Multiflexmeter/Multiflexmeter/readme.md

# Multiflexmeter V4
Frequent, low-cost and flexible measurements using the MultiFlexMeter. An Open-Source sensor platform.

## Documentation

- [Firmware Documentation](https://multiflexmeter.github.io/multiflexmeter)
- [Hardware specification](./docs/P22296-1-SPEC-2.0.pdf)
- [Firmware specification](./docs/P22296-10-SPEC-2.0.pdf)
