Multiflexmeter/Multiflexmeter/accessories/well_adapter_115mm_160mm/readme.md

## Well adapter

3D printable files for attaching a MFM to a groundwater well of two diameters (115mm and 160mm). Including a mounting cap and side adapter.

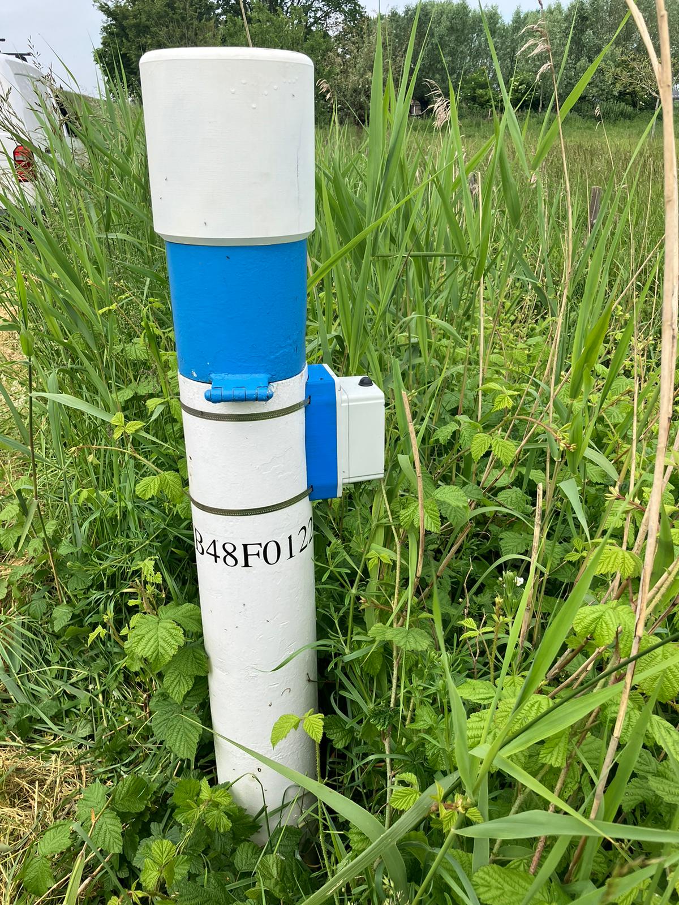
[picture p1: accessories/well_adapter_115mm_160mm/IMG-20240524-WA0001.jpg]
Sideview of a groundwater well with a MultiFlexMeter attached to it using this adapter


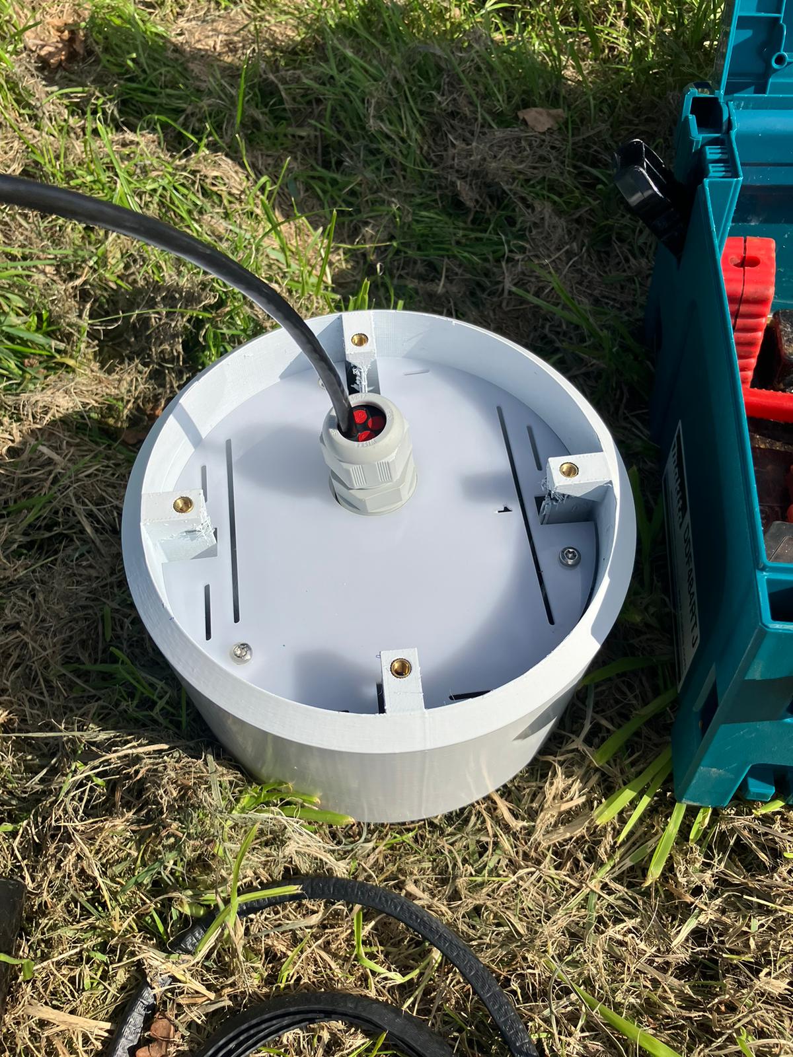
[picture p2: accessories/well_adapter_115mm_160mm/IMG-20241004-WA0002.jpg]
Assembled but not attached groundwater well cap view
