Multiflexmeter/Multiflexmeter/accessories/well_adapter_115mm_160mm/3D Well Cap temporary.step

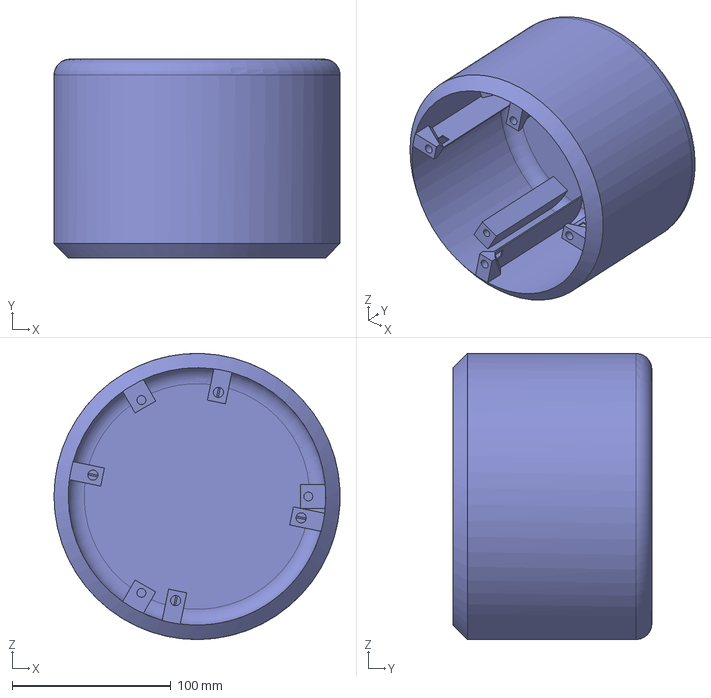
[picture p13: CAD file, 2025-04-15]
accessories/well_adapter_115mm_160mm/3D Well Cap temporary.step
179.9 x 125.0 x 180.0 mm
