Multiflexmeter/Multiflexmeter/accessories/well_adapter_115mm_160mm/Adapter_MFM-V4_160mm.SLDPRT

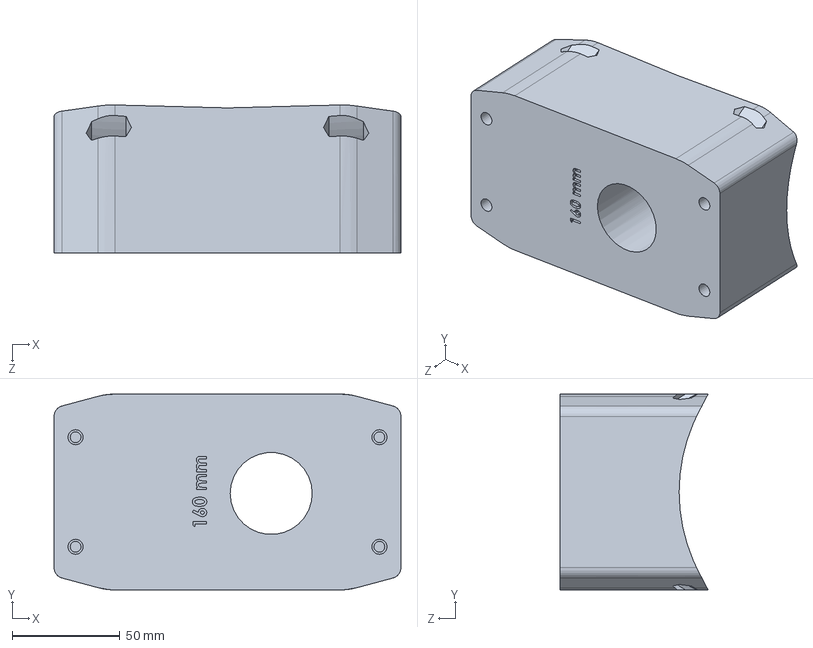
[picture p14: CAD file, 2025-04-15]
accessories/well_adapter_115mm_160mm/Adapter_MFM-V4_160mm.SLDPRT
160.8 x 90.8 x 68.6 mm
