Multiflexmeter/Multiflexmeter/accessories/well_adapter_115mm_160mm/Adapter_MFM-V4_115mm.SLDPRT

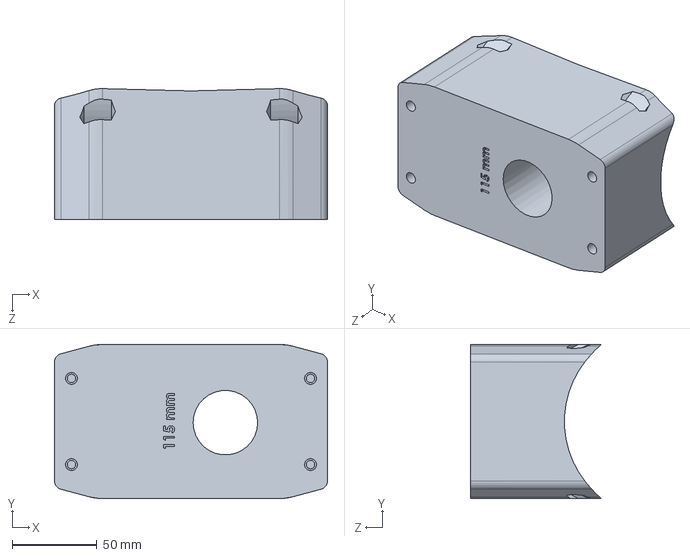
[picture p15: CAD file, 2025-04-15]
accessories/well_adapter_115mm_160mm/Adapter_MFM-V4_115mm.SLDPRT
160.8 x 90.8 x 77.0 mm
