Multiflexmeter/Multiflexmeter/accessories/well_adapter_115mm_160mm/3D Cap Electronics platform 160mm.step

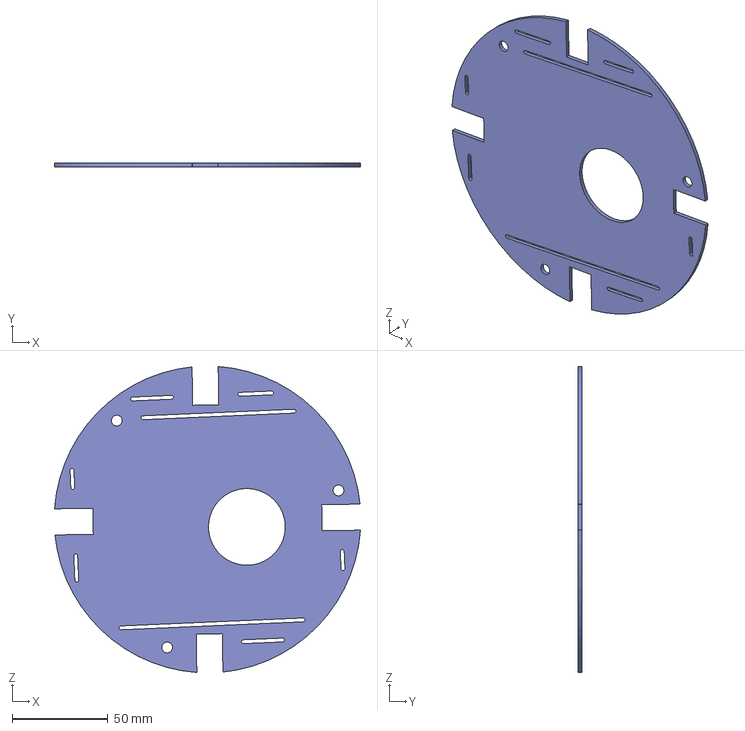
[picture p16: CAD file, 2025-04-15]
accessories/well_adapter_115mm_160mm/3D Cap Electronics platform 160mm.step
159.6 x 2.00 x 159.6 mm
