Multiflexmeter/Multiflexmeter/(list of files, cad)

Other CAD files:
accessories/well_adapter_115mm_160mm/3D Well Cap 160mm.stl
accessories/well_adapter_115mm_160mm/Adapter_MFM-V4_115mm.STL
accessories/well_adapter_115mm_160mm/Adapter_MFM-V4_160mm.STL
