Multiflexmeter/Multiflexmeter/(list of files, drawings)

Other design files:
hardware/BatteryMonitor.SchDoc
hardware/MCU.SchDoc
hardware/MCU_RF.SchDoc
hardware/Mechanical.SchDoc
hardware/Memory.SchDoc
hardware/P22296-1.PrjPcb
hardware/Power1.SchDoc
hardware/Power2.SchDoc
hardware/Revison Table.SchDoc
hardware/RTC.SchDoc
hardware/Sensor.SchDoc
hardware/SensorSlot1.SchDoc
hardware/SensorSlot2.SchDoc
hardware/TopLevel.SchDoc
hardware/USB.SchDoc
