Multiflexmeter/Multiflexmeter/src/Core/Src/main.c

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
/* Includes ------------------------------------------------------------------*/
#include "main.h"
#include "crc.h"
#include "app_fatfs.h"
#include "i2c.h"
#include "iwdg.h"
#include "app_lorawan.h"
#include "spi.h"
#include "usart.h"
#include "gpio.h"

/* USER CODE BEGIN Includes */
#include "sys_app.h"
#include "../../App/mainTask.h"
#include "../../App/productiontestTask.h"
#include "../../App/CommConfig.h"
#include "../../App/dataflash/dataflash_functions.h"
#include "../../App/measurement.h"
#include "../../App/MFMconfiguration.h"
#include "../../App/common/common.h"
/* USER CODE END Includes */


/* USER CODE BEGIN PV */
#ifdef  USE_FULL_ASSERT
uint32_t assert_failed_count;
#endif
/* USER CODE END PV */

void SystemClock_Config(void);
/* USER CODE BEGIN PFP */

void SystemClock_Config_MSI_RC(void);


/* USER CODE END PFP */

/* USER CODE BEGIN 0 */
static int8_t resultInitDataflash;

#ifdef ERASE_DATAFLASH
#warning ERASE_DATAFLASH at boot enabled
bool chipErase = true;
#endif

#ifdef ERASE_VIRTUAL_EEPROM
#warning ERASE_VIRTUAL_EEPROM at boot enabled
bool eraseVirtualEeprom = true;
#endif

/* USER CODE END 0 */

/**
  * @brief  The application entry point.
  * @retval int
  */
int main(void)
{
  /* USER CODE BEGIN 1 */
  detectResetBackup(); //detect if the vBAT backup domain is reset, must be executed before init.
  /* USER CODE END 1 */

  /* MCU Configuration--------------------------------------------------------*/

  /* Reset of all peripherals, Initializes the Flash interface and the Systick. */
  HAL_Init();

  /* Configure the system clock */
  SystemClock_Config();

  /* Initialize all configured peripherals */
  MX_GPIO_Init();
  MX_CRC_Init();
  MX_SPI1_Init();
  MX_I2C1_Init();
  MX_I2C2_Init();
  MX_FATFS_Init();
  MX_LoRaWAN_Init();
  MX_USART2_UART_Init();
  MX_IWDG_Init();
  /* USER CODE BEGIN 2 */

  uartInit_Config();
  resultInitDataflash = init_dataflash();

#ifdef ERASE_DATAFLASH
  if( chipErase )
  {
    chipEraseDataflash();
  }
#endif

#ifdef ERASE_VIRTUAL_EEPROM
  if (eraseVirtualEeprom == true)
  {
    eraseVirtualEEPROM();
  }
#endif

  restoreLatestMeasurementId();
  reloadSettingsFromVirtualEEPROM();

  APP_LOG(TS_OFF, VLEVEL_H, "Testmode: %d\r\n", getStatusRegister().testmodeActive);

  /* check production testmode is active or normal operation mode */
  if( getStatusRegister().testmodeActive )
  {
    init_productiontestTask();
  }
  else if( getStatusRegister().testmodeBatteryGauge )
  {
    init_batmonConfigTask();
  }
  else
  {
    init_mainTask();
  }

  /* USER CODE END 2 */

  /* Infinite loop */
  /* USER CODE BEGIN WHILE */
  while (1)
  {
    /* USER CODE END WHILE */
    MX_LoRaWAN_Process();

    /* USER CODE BEGIN 3 */
  }
  /* USER CODE END 3 */
}

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
