Multiflexmeter/Multiflexmeter/src/App/dataflash/dataflash_functions.c

/*
 * dataflash_functions.c
 *
 *  Created on: 23 aug. 2023
 *      Author: p.kwekkeboom
 */

#include "spi_driver.h"
#include "standardflash.h"
#include "helper_functions.h"
#include "dataflash_functions.h"

static uint8_t MID[] = {0x1F, 0x88, 0x01};
static uint8_t dataRead[MAXIMUM_BUFFER_SIZE] = {0};


static uint8_t writePageBuffer[PAGE_SIZE_DATAFLASH];
static uint8_t readPageBuffer[PAGE_SIZE_DATAFLASH];
static uint8_t block4kBuffer[BLOCK_4K_SIZE_DATAFLASH];

/**
 * @fn const void setup_io_for_dataflash(bool)
 * @brief weak function to be override in application for enable I/O for FRAM operations
 *
 * @param state
 */
__weak const void setup_io_for_dataflash(bool state)
{
  UNUSED(state);
  __NOP();
}

/**
 * @fn void standardflashWaitOnReadyWithTimeout_printResult(void)
 * @brief helper function to catch the result.
 *
 */
void standardflashWaitOnReadyWithTimeout_printResult(void)
{
  bool result = standardflashWaitOnReadyWithTimeout();

  if ( result )
  {
    APP_LOG(TS_OFF, VLEVEL_H, "DATAFLASH: ERROR, timeout at Wait on ready\r\n");
  }
}


/**
 * @fn int init_dataflash(void)
 * @brief function to initialize the Dataflash I/O and read the Manufacturer ID
 *
 * @return 0 = success, -1 = failed.
 */
int8_t init_dataflash(void)
{
  int result = 0;
  //enable io needed for dataflash
  setup_io_for_dataflash(true);

  // initialize the I/O
  SPI_ConfigureSingleSPIIOs();

  //read the MD to verify dataflash
  standardflashReadMID(dataRead);

  //check MID is okay
  if (compareByteArrays(dataRead, MID, 3))
  {
    APP_LOG(TS_OFF, VLEVEL_H, "Dataflash: ReadMID Success.\r\n");
    result = 0;
  }
  else
  {
    APP_LOG(TS_OFF, VLEVEL_H, "Dataflash: ReadMID fail.\r\n");
    result = -1;
  }

  //disable io needed for dataflash
  setup_io_for_dataflash(false);

  return result;
}

/**
 * @fn int8_t writePageInDataflash(uint32_t, uint8_t*, uint32_t)
 * @brief function to write a page in dataflash
 *
 * @param pageAddress : start address of page, must be align on page size \ref PAGE_SIZE_DATAFLASH
 * @param data : pointer to data buffer to write, no zero.
 * @param length : length of data to write, must be > 0
 * @return 0 = successful, -1 = data pointer is zero, -2 = length is zero, -3 = length is larger then one page size \ref PAGE_SIZE_DATAFLASH
 */
int8_t writePageInDataflash(uint32_t pageAddress, uint8_t * data, uint32_t length)
{
  assert_param(data != 0 ); //check pointer is not zero
  assert_param(length != 0 ); //check length is not zero
  assert_param(length <= PAGE_SIZE_DATAFLASH ); //check length is not too large

  if( data == 0 ) //check pointer is zero
  {
    return -1;
  }

  if( length == 0 ) //check length is zero
  {
    return -2;
  }

  if( length > PAGE_SIZE_DATAFLASH ) //check length is larger then 256
  {
    return -3;
  }

  //enable io needed for dataflash
  setup_io_for_dataflash(true);

  //set pageBuffer as empty value
  memset(writePageBuffer, 0xff, sizeof(writePageBuffer));

  //read dataflash block
  standardflashReadArrayLowFreq(pageAddress, dataRead, length < sizeof(dataRead) ? length : sizeof(dataRead));

  //check if location is empty
  if (memcmp( dataRead, writePageBuffer, sizeof(writePageBuffer)) )
  {
    APP_LOG(TS_OFF, VLEVEL_H, "Page %d is not empty.\r\n", pageAddress);
  }

  //enable write
  standardflashWriteEnable();

  //write data
  standardflashBytePageProgram((uint32_t)pageAddress, data, length);

  //wait for ready
  standardflashWaitOnReadyWithTimeout_printResult();

  //disable io again
  setup_io_for_dataflash(false);

  return 0;
}

/**
 * @fn int8_t writeMeasurementInDataflash(uint32_t, uint8_t*, uint32_t)
 * @brief function to write a measurement item "measurementId" in the dataflash ringbuffer.
 *
 * @param measurementId number starts from 0 - 4294967296
 * @param data array of data
 * @param length of data array to write, limit to 256 (\ref PAGE_SIZE_DATAFLASH).
 * @return 0 = successful, -1 = data pointer is zero, -2 = length is zero, -3 = length is larger then one page size \ref PAGE_SIZE_DATAFLASH
 */
int8_t writeMeasurementInDataflash(uint32_t measurementId, uint8_t * data, uint32_t length)
{
  assert_param(data != 0 ); //check pointer is not zero
  assert_param(length != 0 ); //check length is not zero
  assert_param(length <= PAGE_SIZE_DATAFLASH ); //check length is not too large

  if( data == 0 ) //check pointer is zero
  {
    return -1;
  }

  if( length == 0 ) //check length is zero
  {
    return -2;
  }

  if( length > PAGE_SIZE_DATAFLASH ) //check length is larger then 256
  {
    return -3;
  }

  uint64_t pageAddress = (measurementId * PAGE_SIZE_DATAFLASH);
  pageAddress %= MEASUREMENT_MEMEORY_SIZE;

  return writePageInDataflash((uint32_t)pageAddress, data, length);
}
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
