Multiflexmeter/Multiflexmeter/(commit log)

2023-04-13 intial commit.
    Project generated with ioc file saved in "P22296-10-SW IOC stm32 template 2023-04-13.zip"
    Settings based on example "LoRaWAN_End_Node".
2023-04-13 change: add "../Drivers/BSP/STM32WLxx_Nucleo" to include path in eclipse project settings.
2023-04-13 change: take over changes of LoraWAN_End_Node changes of example. Extra: place LED driving betweend #ifdef.
2023-04-24 change: enable TIM2 with interrupt for app timer.
2023-04-24 change: enable debugger. Use Undef to prevent every time reset by code generation.
    [sys_conf.h]
2023-04-24 change: disable TIM2, does not work with STOP2 mode. Hardware error.
    [main.c, stm32wlxx_it.c]
2023-04-25 change: correct #ifdef for LED2.
    [lora_app.c]
2023-04-25 change: add app/common files app_types.h and uart.c
2023-04-25 change: add some code for uart config handling.
2023-05-11 change: basis implementation of uart CONFIG send / read structure.
2023-05-11 change: enable UART callback in IOC and code.
2023-05-16 fix: switch arround by mistake of commandGet / commentSet
    [CommConfig.c]
2023-05-16 fix: wrong assert sign is used.
    [CommConfig.c]
2023-05-17 change: add commands Get+SensorInfo, Get+JoinID, Get+DeviceID, Get+AppKey
2023-05-17 change: add command Get+Sensor=X
2023-05-22 fix: correction of number of arguments of Get+LeesInterval en Get+MeetTijd
    [CommConfig.c]
2023-05-22 change: add new command Set+Sensor
2023-05-22 fix: skipp comma reading.
    [CommConfig.c]
2023-08-11 Add: Enable I2C1 for the internal bus with internal pullups for testing
2023-08-11 Add: Added library from ambic and changed the private functions to work with STM32
    (cherry picked from commit c0532baad6d5c6d7373273510c6734e729f9e088)
2023-08-11 Changed i2c handle from i2c2 to i2c1
2023-08-11 change: add set DeviceId command to overrule chip deviceId
2023-08-11 Refactor: Corrected the indentation and whitespacing
    [am1805.c, am1805.h]
2023-08-16 change: set at init LoraWan : ADREnable = false and Datarate = DR_2 (SP10). Decrease Datarate if join failed.
    [lora_app.c]
2023-08-16 Revert "change: config, Lorawan version from 1.0.3 to 1.0.4 in cubeMx project file"
    This reverts commit 7ef1d0bc230a0cca72d6b3f9c399aeb51bf8f0e7.
    [P22296-10-SW.ioc]
2023-08-16 Change: tested am1805_sqw_set. Works on pin CKO but not on FOUT or PSW pin. Alarm function also doesn't work on these pins.
    [am1805.c, am1805.h, main.c]
2023-08-16 Docs: Updated the comments to only AM1805 because SPI is not supported/needed at the moment
2023-08-16 Change: Added global define for the i2c handle
2023-08-16 change: add *.launch file, *.stackdump and .settings/stm32cubeide.project.prefs to ignore. Files can give conflicts if changes are commit.
2023-08-16 Add: Add library for communicating to the sensor module
    (cherry picked from commit 20ac5bdaa4915cb763f8f0591adfdb417dcb24e0)
2023-08-16 Add: added files for the battery monitor with basic defines for the registers and commands
    (cherry picked from commit 646b38ebbe7aba5a357235ba6925f0fcf9704114)
2023-08-16 Add: added read voltage function and tested the init and read voltage functions
2023-08-16 change: enable SPI1 on PA5, PA6, PA7 in configuration file stm32cube
2023-08-16 Add: Added read current and temperature functions
2023-08-16 Change: changed the i2c handle to variable to a pointer so a check can be done if it isn't NULL
2023-08-17 change: add sourcefiles from https://github.com/adestotechnologies/Flash-Drivers/tree/master/source Not yet compilable
2023-08-17 change: modify library to compile without error. Not yet working.
    [main.c, standardflash.c, user_config.c, user_config.h]
2023-08-17 change: prevent warnings of printing uint32.
    [helper_functions.c, test.c]
2023-08-18 Add: added security mode check. always results in 0 because the and operation is not working correctly. Needs to be fixed.
    [bq35100.c, bq35100.h, main.c]
2023-08-18 Add: added function to get the design, used and remaining capacity
2023-08-21 Add: added gauge enable and disable functions. Disable function is pretty long in now. Need to add a parameter to ignore the checking if the device is really off.
2023-08-21 Change: added parameter to skip the check function to save time
    [bq35100.c, bq35100.h, main.c]
2023-08-21 Change: added commands directly to i2c function
2023-08-21 Fix: fixed the get security mode function
    [bq35100.c, bq35100.h, main.c]
2023-08-23 Change: added the internal temperature function and changed output form float to a int16_t to minimize the size needed.
2023-08-23 change: add dataflash device AT25QF641B. has different manufacturer ID. 0x1f 0x88 0x01.
2023-08-23 change: macro for printing debug information of driver to debug com-port.
2023-08-23 Revert "change: add testcode for dataflash testing."
    This reverts commit dc5340fcaeee9f2e60473f04ce80dc56ec418ca1.
    [main.c]
2023-08-23 change: move printf override to helper_functions.h
2023-08-23 Fix: used printf for logging does not support %lu.
    [helper_functions.c]
2023-08-23 change: addon "dataflash" in print log.
2023-08-24 Revert "change: testing dataflash test function."
    This reverts commit 3ff5dd0403358a8ca5541797c43011fefc0e8966.
    [main.c]
2023-08-24 Revert "change: testcode to verify function arguments."
    This reverts commit c85f6f5a128558a50869bf7b8cdb23863726166c.
    [main.c]
2023-08-25 Revert "change: test temporary with smaller ring buffer."
    This reverts commit 816dbefc2b79bc19a6899810e834cc69d34243df.
    [dataflash_functions.h]
2023-08-30 Revert "change: add testcode for dataflash write and searching."
    This reverts commit 2c311ad7943dbc62c44c683d2f1c77fdde448cbf.
    [main.c]
2023-08-30 Change: fixed enable function
    [bq35100.c]
2023-08-31 change: add function to activate uart in listen mode until timeout.
2023-08-31 change: test code to activate uart config listing at every TX send period. Needs to change to activation by USB connection.
2023-08-31 change: fix on 8347306d37b9b11098eccd103a8118cd8ef49ab1 wrong variable name used.
    [CommConfig.c]
2023-08-31 change: implementation of printing the dataDump.
2023-09-04 change: fix in uart interrupt, first check pointer is not zero.
    After a poweron boot the interrupt is triggered when pointer is not yet set.
    This gives an hard fault.
    [uart.c]
2023-09-04 change: add common.c and common.h file with functions for resetCause and backup registers.
    [common.c, common.h]
2023-09-04 change: add check on PowerOnReset() for skipping backup registers.
2023-09-04 change: testcode for delay powerup for testing and debugging.
2023-09-12 Revert "change: testcode for delay powerup for testing and debugging."
    This reverts commit b6daf899d905b69424d6644d9c1f0f0ba6d71e3a.
2023-09-12 change: correction of define name, by mistake 62 must be 64.
    [dataflash_functions.h]
2023-09-13 change: correction of casting variable in printf function
    [CommConfig.c]
2023-09-13 change: reload unique ID when 0x00 is set as DeviceId.
2023-09-13 change: fix to make it possible to read also input of 16 characters or less.
    [CommConfig.c]
2023-09-14 change: add ST driver EEPROM_Emul to project
2023-09-18 change: add clock initialize for XTAL 8Mhz, TCXO 8Mhz, TXCO 32Mhz (nucleo board) and backfall MSI RC
2023-09-19 change: disable (test) erase of virtual memory at powerup.
2023-09-19 change: code change of code generation. Forgotten to revert in commit 049ade5b70a1da988efcd925b8ba6e801321ef29
    [main.c]
2023-09-19 change: return real HAL_GetTick() if RTC timer not yet enabled.
2023-09-19 Change: disable flash init function because fatfs function do not work otherwise. Used another library found at https://github.com/eziya/STM32_SPI_SDCARD
    [P22296-10-SW.ioc, main.c, main.h, spi.c, stm32wlxx_it.c]
2023-09-20 Change: made use of the hal spi function. Can be toggled by define in spidriver.h. IO method is faster but can be used simultaneously with the sd card
2023-09-20 Change: disabled hal function spi for now because SD card is not attached
2023-09-20 Change: sped up the spi transmit by sending and receiving multiple bytes instead of byte for byte. 10ms faster.
2023-09-20 Change: disable hal spi driver
2023-09-22 change: temporary disable TCXO for Dekimo board, gives troubles with clock init.
2023-09-26 change: add counter for monitoring time request sending/receiving. Failed sometimes.
    [lora_app.c]
2023-09-27 change: enable HAL driver for dataflash.
2023-09-27 change: add functions to read ADC
2023-09-27 change: add commands for software version and ADC test.
2023-09-27 change: lower the SPI speed, because of problems on evaluation board with SD card reading. TODO: on target board to higher frequency.
    [P22296-10-SW.ioc]
2023-09-27 change: change: lower the SPI speed, because of problems on evaluation board with SD card reading, only code change of 1ff1333a45433c9c3a4ca0e753d30ac544f4395d.
    [spi.c]
2023-09-27 change: cubeMx configuration file, make sure CS for SD is high at power.
2023-09-27 change: Make sure CS for SD is high at power. code change of previous commit 8e6d512d24e55d91f38071ffa9d9c80e46212d63
2023-09-28 change: call power_off() when init failed and implement of return power status command.
2023-09-28 change: remove double definition. Use definition of "diskio.h" from STM32 example project of http://elm-chan.org/
2023-09-28 change: replace fatfs timer function for disk_timerproc().
    [stm32wlxx_it.c]
2023-09-28 change: expand SD test with capacity and number of bytes free
2023-09-28 change: move I2CMaster files
2023-09-29 change: trigger uartListen for debug/testing
2023-09-29 change: code generation of Wakeup pin PA4
2023-09-29 change: configuration cubeMX enable "Set all free pins as analog (to optimize the power constumption).
2023-09-29 change: code change of previous commit 833b183b65654f7cb7d10b36bf333ba29684ef24 configuration cubeMX enable "Set all free pins as analog (to optimize the power constumption).
2023-09-29 change: add wake-up interrupt
2023-09-29 Revert "change: configuration cubeMX enable "Set all free pins as analog (to optimize the power constumption)."
    This reverts commit 833b183b65654f7cb7d10b36bf333ba29684ef24.
    [P22296-10-SW.ioc]
2023-09-29 Revert "change: configure Wake-up 0 (PA0)"
    This reverts commit fd2492f919e001a4be26095d0180f95f2230bd33.
    [P22296-10-SW.ioc]
2023-09-29 Revert "change: code generation of Wakeup pin PA4"
    This reverts commit 66540e15caf5f866161f55a1b026fc140ec32357.
    [main.h]
2023-09-29 change: code change of previous commit e8b44b3a607451c4b2983a05ee77be215bd47c60. Enable PC13 as wakeup pin.
2023-09-29 Revert "change: code change of previous commit e8b44b3a607451c4b2983a05ee77be215bd47c60. Enable PC13 as wakeup pin."
    This reverts commit 97e88effcbbb649effed55e8c3ba2f9439287230.
    [main.h]
2023-09-29 Revert "change: enable PC13 for wake-up in cubeMx configuration file"
    This reverts commit e8b44b3a607451c4b2983a05ee77be215bd47c60.
    [P22296-10-SW.ioc]
2023-09-29 change: save CLK configuration before STOP2 mode, set back enter wake up.
    Otherwise the clock runs too slow and uart receive will not work.
    [stm32_lpm_if.c]
2023-10-03 Revert "change: read out time for testing."
    This reverts commit f73e5a435a7cf48123a6e7ec58cbe828f315ef8e.
    [stm32_lpm_if.c]
2023-10-03 Revert "change: test on clk before resume"
    This reverts commit 15d1db8b26a282e45e9fa882a10037ab539c8b4f.
    [stm32_lpm_if.c]
2023-10-03 Revert "change: test code to activate uart config listing at every TX send period. Needs to change to activation by USB connection."
    This reverts commit beee27ae158b35c99e2c04949711035b672f46f7.
    [lora_app.c]
2023-10-03 change: cubeMx only, enable I2C channel 2 on PA11 and PA12. Standard mode 100Khz.
2023-10-03 change: code change of enable I2C channel 2
2023-10-04 change: add TCA9535 I2C driver, based on SLVC564 I/O Expander Software and Firmware Package (https://www.ti.com/tool/download/SLVC564)
2023-10-05 change: rewrite some functions to handle a more flexiable way for supporting multiple I/O expanders on different address and on different I2C bus peripherals.
2023-10-05 change: process return value of I2C_Write() in init.
2023-10-05 change: make difference between powerup and wakeup from STOP2
2023-10-09 change: add set/reset functions for register variable
    [IO_Expander.c]
2023-10-09 change: use set/reset register function.
    [IO_Expander.c]
2023-10-10 change: add a first definition of board_io
2023-10-10 change: split up init function with init a pin.
2023-10-10 change: implement init function of board IO (only of IO expander).
2023-10-10 change: fix invert IS_GPIO_PIN()
    [IO_Expander.c]
2023-10-10 change: add functions to update, write and read board IO. Also rewrite of IO expander functions related to new functions
2023-10-10 change: use defines for port definition based on target NUCLEO (evaluation board) or Dekimo board.
2023-10-11 Change: add LED functions
2023-10-11 change: add LED test function call from command
2023-10-11 change: prevent double definition of true and false
    [app_types.h]
2023-10-11 change: call init LED timer to start LED functions
2023-10-11 Add: enabled I2C2
2023-10-11 Add: added function to set the amount of samples and updated the register sizes
2023-10-11 Add: added read samples function
2023-10-12 Add: added read and write setup time of the sensor
2023-10-12 change: use LED1 and LED2 of evaluation board.
2023-10-12 fix: worng enum type was used.
    [board_io.c, board_io.h]
2023-10-12 change: make board_io functions const
2023-10-12 change: rewrite led function to support mode (LED_DISABLED) for direct control of I/O of output by board_io functions.
2023-10-12 change: add missing comments and doxygen header.
    [CommConfig.c]
2023-10-13 change: I2C-2 was allready enabled in cubeMx file, but item was missing ",14-MX_I2C2_Init-I2C2-false-HAL-true" in config file.
    [P22296-10-SW.ioc]
2023-10-13 change: Lora protocol version from 1.0.3 to 1.0.4.
    Needed for resume session after power down without a new Join.
    Protocol version 1.0.3 will cause every powerdown cycle a new Join.
2023-10-13 change: correct device type FRAM
    [FRAM.c]
2023-10-16 Change: CubeMx config file for UFQFPN48 device.
2023-10-17 change: disable other CLOCK inits (executing failed on current target).
    [main.c]
2023-10-17 change: Use dekimo board, not nucleo defines for Port IO.
2023-10-17 change: add test code for toggle LED, for board testing.
2023-10-18 Enable i2c interrupts
2023-10-18 Fix: wrong index was used.
    [IO_Expander.c]
2023-10-18 fix: wrong argument checking sign was used.
    [TCA9535.c]
2023-10-18 fix: shift address one position.
    [TCA9535.c]
2023-10-18 change: test code for I2C scanning.
2023-10-19 Add: added read function for the selected sensor
2023-10-23 change: rewrite of I/O expander init function for call init for each device separatly.
2023-10-23 change: I2C peripheral device switched arround
2023-10-23 Fix: wrong index used in I2C_write
    [TCA9535.c]
2023-10-25 change: add uart test function, for hw test.
2023-10-25 Revert "change: testing Usart1."
    This reverts commit fdb8d45ce989963a1ea92f92f662ed31ff5c1532.
    [main.c]
2023-10-25 Revert "change: disable some items for testing usart1."
    This reverts commit 0f2a975731eae5200b96759f76868161385e24c1.
    [main.c]
2023-10-25 Revert "change: add uart test function, for hw test."
    This reverts commit 57283215712961c49bb981143eb5d47e09791bcd.
    [CommConfig.c, main.c]
2023-10-25 change: use inverted level for IO_LOW_ACTIVE pins.
    [board_io.c]
2023-10-25 change: enable SPI.
2023-10-25 Revert "change: test dataflash hardware test."
    This reverts commit b1e8e8c41e6c4aef28c4098c13e4462e84ec144d.
    [main.c]
2023-10-25 change: implement board specific LoRa FE_control
2023-10-25 change: enable other items, cleanup test code I2C
2023-10-26 change: use right CS pin for SD card.
2023-10-26 change: first enable SPI before LoraWan. Needed if NVIC data is saved in FRAM. Temporary outside cubeMx. Needs to be done in CubeMx.
2023-10-26 change: order of periperhal init, move SPI init before LoRaWAN init. Only CubeMx file.
2023-10-26 change: code generation of previous commit. Order change SPI before LoraWan.
2023-10-26 change: I2C move before LoraWan init
2023-10-26 change: move I2C init before LoraWan Init. Code change of previous commit.
2023-10-26 Revert "change: code change of previous commit. Order of init periperhals. Place LoraWan_init at end. Place usart together. Place CRC in front."
    This reverts commit a4639beebcb14ac972889dd1c80e4309d09d0931.
    [main.c]
2023-10-26 test: temporary set LED1 to blink for test.
2023-10-30 change: correct PC13 from input to output. Only CubeMx config file
    [P22296-10-SW.ioc]
2023-10-31 change: correct OSC clock frequency from 8 to 32Mhz
    [P22296-10-SW.ioc]
2023-11-06 fix: by mistake struct definition and filling of stIO_PinConfig the first two column switch arround.
    [board_io.h]
2023-11-06 Fix: fixed the 2nd IO expander not working
    [board_io.h]
2023-11-06 change: add test functions for Battery monitor
2023-11-07 fix: blocknumber must be multiplied with blocksize, to get the right start address.
    [dataflash_functions.c]
2023-11-07 fix: clear argument string, if no arguments are available.
    [CommConfig.c]
2023-11-07 change: add functions to switch input/output.
2023-11-07 Change: enabled the interrupt of the I2C2 bus because otherwise the measurement communication fails
    [P22296-10-SW.ioc]
2023-11-07 Change: updated files for enabled I2C interrupt
2023-11-09 Remove: removed sensor data structs because data lenght is provided via the I2C communication
2023-11-21 change: trigger save NVM to FRAM in SendTxData() gives problems with receiving data on gateway. Trigger moved to OnTxTimerEvent().
    [lora_app.c]
2023-11-22 change: expand I2C sensor functions with datalength argument
2023-11-22 change: split up board_io functions in plane board_io, test and functional.
2023-11-22 change: add function to control sensor slot power.
2023-11-22 fix: on a8da4a8f9e00dc645ac8454469836140223e411c. Needs to be memset(), not memcpy().
    [I2C_Master.c]
2023-11-22 change: rewrite of sensor functions with the use of sensor number, not I2C address.
2023-11-22 change: rewrite enum I2C error.
    [I2C_Master.c, I2C_Master.h]
2023-11-22 change: rewrite sensor function return type.
2023-11-22 change: correction no dataLength needed.
    [SensorFunctions.c, SensorFunctions.h]
2023-11-22 change: add missing funtion in header.
    [MFMconfiguration.h]
2023-11-22 change: add a first implementation of reading sensor data.
2023-11-22 change: some improvements and new features: save module ID to FRAM, read module ID at start. Fix in increment ModuleId. Switch off power of slot after measure.
    [FRAM_functions.c, FRAM_functions.h, mainTask.c]
2023-11-23 fix: calculate supply for VBUS measure.
    [CommConfig_usr.c, common.h]
2023-11-27 fix: [2] is too less, needs to be at least [3] for null terminator. [] also works fine.
    [CommConfig.c]
2023-11-27 change: add enum for sensor types and struct for sensor data type for debug purposes only.
2023-11-27 change: add debug print of formated sensor data.
2023-11-27 Fix: getSensorStatus() uses sensor number from 1-6, for communication and algoritme 0-5.
    [mainTask.c]
2023-11-28 change: expand log function with sensor slot Id.
2023-11-28 change: update mainTask to measure pericall one sensor module and trigger the SendTxData (lora transmit).
2023-11-28 change: update tx interval in Lora_app based on max of forced and current. Reading setting lora_interval removed, done in MainTask now.
2023-11-28 fix: user code on wrong location.
    [lora_app.c]
2023-11-28 change: save NVM data after TX in lora_app.c and if tx failed in mainTask
    [lora_app.c, mainTask.c]
2023-11-28 change: expand logdata with sensor protocol
2023-11-28 change: rewrite of sensorFunctions with error result.
    [SensorFunctions.c, SensorFunctions.h, app_types.h, mainTask.c]
2023-11-28 change: cubeMx file. Lower prescaler from 8 to 2. SPI baudrate lowered because of internal clock 48Mhz -> 4Mhz from 6Mbits/s -> 500KBits/s. With prescaler on 2 it will be 2.0Mbits/s
2023-11-28 change: cubeMx file 4Mhz to 2Mhz. SPI degrades from 2.0Mbits/s to 1.0Mbits/s
2023-11-29 change: move resume mainTask to MainTask measurement timer.
2023-11-29 change: rewrite UartConfig active with TIMER
2023-11-29 change: trigger uart to accept data.
2023-11-29 change: add uartKeepListen() function to keep uart in listen mode (no STOP2 mode will be active).
2023-11-29 change: get USB connected input to set uartKeepListen(). If USB is connected the STOP2 mode is not activated.
2023-11-29 change: move board I/O functions from mainTask.c to board_io_functions.c
2023-11-29 change: add init_board_io_device() to init each device seperatly.
2023-11-29 change: also switch on/of vSys for test FRAM function
2023-11-29 change: some optimization for speed / power.
2023-11-29 change: save sensor protocol and type globally in mainTask.c, so it can be used at later state. This saves some time / energy.
2023-11-30 change: enable green LED by Lora Uplink
2023-12-04 change: add application functions to measure battery monitor data
2023-12-04 change: add measure battery monitor in mainTask
2023-12-04 Fix: remove komma at end of line.
    [mainTask.c]
2023-12-04 change: move init batMonitor to mainTask Must be after board "init_board_io()"
2023-12-04 change: rewrite mainTask to wait for Battery measuredment data.
2023-12-04 change: save request time to backup registers, to prevent every switch off by RTC a downlink.
    [common.h, lora_app.c, lora_app.h]
2023-12-04 change: print also number of seconds in sleep.
2023-12-04 change: use minimum of 10sec sleep. With 1 second it failed.
    [mainTask.c]
2023-12-04 change: default switch OFF led.
2023-12-06 change: implement of sens vAlways with debug print.
2023-12-06 Fix: make sure I2C wait time for BQ35100 is at least 110ms
    [bq35100.c]
2023-12-06 change: add functions to check battery monitor status.
2023-12-06 Fix: sometimes worstcause is larger. Increase to 150ms.
    [bq35100.c]
2023-12-06 change: a deinit is needed for I2C I/O expander, because vSys is disabled.
2023-12-06 change: add function to detect I2C error
    [i2c.c]
2023-12-06 change: rewrite mainTask for Battery monitor gauge.
2023-12-06 change: only initialize I2C I/O expander on sys bus.
2023-12-06 fix: add missing control of vSys.
    [dataflash_functions.c]
2023-12-06 change: also print wait time when no RTC is used.
2023-12-07 change: add new function to set sleep with alarm, not with countdown. Countdown is not accurate with values larger then 256 seconds, resolution of 1/60Hz => 60 seconds.
2023-12-07 change: add debug print of time NOW and WAKE.
2023-12-07 change: print sync time to debug port.
2023-12-07 fix: correct using the right variable sizeof.
    [RTC_functions.c]
2023-12-07 change: interrupt type of alarm. Level looks like doesn't work okay.
    [RTC_functions.c]
2023-12-07 change: print wakeup ALARM and BAT. Also request time if BAT alarm is active.
2023-12-07 change: do not print sensor data if some error is active. Make sure array is erased then.
    [mainTask.c]
2023-12-07 change: debug print of sync time.
2023-12-07 change: add function to detect reset of vBAT backup domain.
    [common.c, common.h]
2023-12-07 change: detect reset of vBat backup domain at powerup.
    [main.c]
2023-12-07 change: use backup reset for search dataflash pointer and print backup reset.
2023-12-08 Fix: other method for measuring active time. With sysTimeGet() it doesn't work well, because this time is synchronised in between.
    [mainTask.c]
2023-12-08 change: rewrite of RTC status register flags reading. Optimize: Prevent multiple unneccesary reads.
    [RTC_functions.c, RTC_functions.h, mainTask.c]
2023-12-08 change: print also timestamp.
2023-12-08 change: when no sensor slot is enabled, force an interval to wait.
2023-12-08 change: test, print battery info also after TX.
2023-12-12 change: cast value, not a real problem
    [bq35100.c]
2023-12-12 change: make helper function for battery measurement.
2023-12-12 change: add extra battery measurement to get the R and Z impedances.
2023-12-12 fix: first detect current JOIN status before ADR and datarate is set.
    [lora_app.c]
2023-12-12 change: add definition for MFM sensor data and MFM main data for logging.
2023-12-12 change: rewrite mainTask for save sensorModule data to dataflash.
2023-12-12 change: use new write log function and also save EOS battery state.
2023-12-12 change: code change of FE_CTRL2 initialize at input. When FE_CTRL2 is set as output the TX current was 34mA (too high), should be < 26mA. In example code of Node_app the pin is not initialized as out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
2023-12-13 Revert "change: set FE_ctrl2 as input in cubeMx file."
    This reverts commit 81a81dfa03340ebfdbcd1f0effa048dbd49b59d3.
    [P22296-10-SW.ioc]
2023-12-13 Revert "change: code change of FE_CTRL2 initialize at input."
    This reverts commit f8b8a4148b890b76c74a48e33d0066b90bb43979.
    Wrong conclussion. RF_SW_CTRL2_PIN was set as output in stm32wlxx_nucleo_radio.c
2023-12-13 change: remove print battery level of evaluation board code.
2023-12-13 change: add send protocol MFM board.
2023-12-13 change: add send battery level EOS mode.
2023-12-13 change: rename "logging" to "measurement" in debug print lines.
2023-12-13 change: cleanup LED2
2023-12-13 change: rename comments and debug prints
2023-12-13 change: correct comment and debug text.
    [measurement.c]
2023-12-13 change: correct function comment.
    [dataflash_functions.c]
2023-12-13 change: correction of comment.
    [mainTask.c]
2023-12-13 change: set/reset rejoin at next interval from mainTask
    [mainTask.c]
2023-12-14 change: move check on forced rejoin and reset join_status, to force DR2 for rejoin.
    [lora_app.c]
2023-12-14 change: rewrite ADR set/reset for Rejoin, otherwise DR_2 setting does not work.
    [lora_app.c]
2023-12-14 change: rewrite ReJoin. Start at powerup for rejoin.
2023-12-14 change: cleanup rejoin after measurement. Allready done before measurement. Optimize in power use.
2023-12-14 change: add testcode for read back measure at error.
    [measurement.c]
2023-12-14 change: at testcode to signal an error in written data.
    [measurement.c]
2023-12-14 change: testcode to verify current data block is empty
2023-12-14 change: fix in argument check of get+MeasureTime
    [CommConfig.c]
2023-12-14 change: wait time from 100ms to 1000ms. Battery gauges needs +/- 15 seconds.
2023-12-14 change: enable debug print for mainTask sleep.
2023-12-15 change: move battery gauge disable, directly after TX peak
2023-12-15 change: modify order of swith on battery guage measurement
2023-12-18 change: move battery measurement states for optimze.
2023-12-18 change: add functions to save and read last EOS battery state.
2023-12-18 change: rewrite of EOS battery measure only once every 24 measures.
2023-12-19 change: add functions for up/down frame counters.
2023-12-19 change: print also up and down frame counters.
2023-12-19 fix: wrong function was used in commit cbe92665b319ef2df65c9623bddbb77740f940f2
    [mainTask.c]
2023-12-19 change: do not devnonce counter, but up frame counter.
2023-12-19 change: add timeout timer to mainTask
2023-12-19 change: enter RTC sleep if no sensormodules are configured.
2023-12-19 change: set current protocol version and version number.
2023-12-19 change: verify length of command, to prevent trigger command on a command which is partly equal
    [CommConfig.c]
2023-12-19 change: implement read sensor module information
2023-12-19 change: send data of all sensor modules.
2023-12-19 change: save sensor type to MFMconfiguration in virtual eeprom
2023-12-19 change: fix must be ID + 1.
    [mainTask.c]
2023-12-21 change: add resistor devider factor. Note: resistors of 2nd proto, not compatible with first proto.
    [CommConfig_usr.c]
2023-12-21 change: enable rising edge interrupt WDI ex2, enable irq ex1 + ex2
2023-12-21 change: print debug status of registers
2023-12-21 fix: wrong register and value used by mistake.
    [am1805.c]
2023-12-21 Fix: wrong argument checked.
    [am1805.c]
2023-12-21 Change: print control1 and control2 register.
2023-12-21 change: print IRQ ex1 and ex2 names for debug.
2023-12-21 change: handling USB attached, no off mode.
2023-12-21 change: reset at new measurement (new interval)
    [mainTask.c]
2023-12-22 Fix: get good alarm date/time.
    [RTC_functions.c]
2023-12-22 change: make sure the delay is short.
    [mainTask.c]
2023-12-22 change: force sensordata to zero, if reading failed
    [mainTask.c]
2023-12-27 change: add function to get Temperature from controller.
2023-12-27 fix: read vref supply, not only adc value.
    [common.c]
2023-12-27 change: fix make function signed for negative temperatures.
    [CommConfig.c, CommConfig_usr.c, CommConfig_usr.h, common.c, common.h, mainTask.c, measurement.h]
2023-12-27 change: convert battery gauge temperature measurement.
2023-12-28 change: add printing battery capacity
2023-12-28 change: move to be sure I2C handle is initialized at powerup.
2023-12-29 change: add reset function
    [common.c, common.h]
2023-12-29 change: add reboot command
    [CommConfig.c]
2023-12-29 change: add missing function comment.
    [CommConfig.c]
2023-12-29 change: add framework for producitonTestTask
2023-12-29 change: fix for resuming task. Just SetPeriod not enought to retrigger the task.
    [productiontestTask.c]
2023-12-29 change: disable I/O expander on sensor bus at powerup, will be enabled in mainTask
2023-12-29 change: make sure error results of TCA9535 write and read function are always returned as negative (error).
    [IO_Expander.c]
2023-12-29 change: add testing function for test VSYS is available, based on the external pullup resistors on the SPI lines.
2023-12-29 change: add missing function definition to the header.
    [board_io_test.h]
2023-12-29 change: add testing vSys switching.
2023-12-29 change: make helper functions for print okay and failed.
    [productiontestTask.c]
2023-12-29 change: add helper function to print test result.
2023-12-29 change: add productiontest I/O expander sensor
2024-01-11 change: cubeMx file changes for pin changes of new hardware of P22296-10-hw-1.2
2024-01-11 change: cubeMx file change for switch arround usart 1 and 2.
2024-01-11 change: cubeMx change of rising to failing, small mistake.
    [P22296-10-SW.ioc]
2024-01-11 change: enable Exti interrupt in CubeMx file
2024-01-11 change: switch arround Uart for configport.
2024-01-12 change: also change uart callback function
2024-01-12 change: modify handling when no sensor is active.
2024-01-17 change: only use PSW pin for the sleep functions. The alarm must only use internal flags. Otherwise the PSW pin is control multiple times.
2024-01-17 change: split up to verify Box_open and USB separate. Also mask issue with active Ex2 status at Alarm wakeup.
    [mainTask.c]
2024-01-17 change: make sure I2C init is called after vSystem is enabled. Otherwise I2C mostly doesn't work.
    [mainTask.c]
2024-01-17 change: fix of sleeptime when no active sensor is found. Must be one day of secondes.
    [mainTask.c]
2024-01-18 change: add/change some debug time prints.
2024-01-18 Fix: century and month conversion corrected. Also add some comment for conversion.
    [RTC_functions.c]
2024-01-18 change: save sensorModuleEnabled in FRAM.
2024-01-18 change: make sure FRAM is read at powerup.
2024-01-18 change: enable debug LED 2
2024-01-18 change: enable orange LED at TX transmit.
2024-01-18 change: make sure Supercap is switch on when NO USB is found, and switch off when USB is found or at sleep.
2024-01-22 change: add print debug info of control SC.
2024-01-22 change: go first to CHECK_USB_CONNECTED, this prints also debug line "USB connected, no off mode".
2024-01-23 change: add new sensor command initialize sensor module
2024-01-23 change: rewrite of sensor module settings in FRAM, for Sensor init prepare
2024-01-23 change: add set/get function for forced sensor init.
2024-01-23 change: add functional code for sensor init triggering.
2024-01-23 change: add serieel command for trigger sensor init.
2024-01-23 change: fix on 9a952cf5b2ffc4dcea254f8a2445d6caf4df0a26
    [mainTask.c]
2024-01-23 change: add check on init command available in sensor module
2024-01-24 change: fix add missing register definition.
    [SensorRegister.c]
2024-01-24 change: correction of mistake in debug text.
    [mainTask.c]
2024-01-24 change: fix in saving / reading sensorModuleId from/to FRAM.
    [mainTask.c]
2024-01-24 change: only proceed when HAL_OK, all other HAL error use return I2C_TIMEOUT.
    [I2C_Master.c]
2024-01-25 Change: print also fields slotId, Protocol and datasize.
2024-01-25 change: measureTime -> number of samples
2024-01-25 change: functional rewrite of reading measuretime from Sensormodule and write number of samples to sensormodule.
2024-01-25 change: add new command set+sample / get+sample
2024-01-26 change: update diagram for change in sensor reading.
2024-01-26 fix: add missing copy of MFM base data from measurement to dataflash.
    [measurement.c]
2024-01-26 change: add missing set true of valid TX action.
    [mainTask.c]
2024-01-29 change: print debug info.
2024-01-30 change: make sure that after change of DevEu, AppKey and JoinId the settings are stored in NVM, rejoin flag is set and reboot is exectued.
    [CommConfig.c]
2024-01-30 change: make sure rejoin is also triggered when USB is attached.
2024-01-30 change: also print devNonce before JOIN. Can help detect problem with wrong DevNonce counter.
    [mainTask.c]
2024-01-30 Revert "change: add function to stop Join."
    This reverts commit f82cf219bf184e32743cb3e28d3a6f1ba5fe143b.
    [lora_app.c, lora_app.h]
2024-01-30 Revert "change: test LoraWan back to 1.0.3 (previous 1.0.4)"
    This reverts commit 1f281d6031b07576f31ccc0fd84224a43640521e.
    [P22296-10-SW.ioc]
2024-02-01 change: Call deinit/init after HAL error. Prevents short freezing SCL lines after a HAL error.
    [I2C_Master.c]
2024-02-01 change: add debug print function for I2C errors
    [I2C_Master.c]
2024-02-09 change: add option for mode for init battery gauge.
2024-02-14 change: detect a double reset within 5 seconds to force a rejoin
    [common.c, common.h, mainTask.c]
2024-02-14 change: rewrite to fix prevent directly in sleep after forced rejoin.
    [mainTask.c]
2024-02-14 change: only save time when a (possible) reset button is pressed.
2024-02-14 change: also trigger a sensor init at forced rejoin with reset.
    [mainTask.c]
2024-02-14 change: make function for print debug info.
2024-02-14 change: rewrite print function to helper function
2024-02-14 change: move debug print sensor data to helper function
2024-02-15 change: add missing sensor data size.
    [mainTask.c]
2024-02-20 change: add timeout for I2C IT functions
2024-02-21 change: fix correct wrong PIN for LED2.
    [board_io.c]
2024-02-21 change: enable LED1 toggle at controller ON.
2024-02-21 change: move enable orange LED to mainTask. In LoraApp toggle doesn't work, because task switch is not done between.
    [lora_app.c, mainTask.c]
2024-02-21 change: enable orange LED at rejoin also.
2024-02-21 change: use interval of 10ms instead of 100ms for LED timer, for faster/shorter blinking.
    [led.c]
2024-02-21 change: correct blinking times for LED
    [led.c]
2024-02-21 change: make sure led toggle/blink always start with ON cycle.
2024-02-21 change: set interval to 2 sec for orange LED
2024-02-22 change: temporary add some debug printing
2024-02-22 change: add debug print for CRC validation of FRAM data
2024-02-22 change: temporary debug print for DevNonce check.
2024-02-22 change: add debug printing for SPI timeouts for FRAM read/write operations.
2024-02-22 change: fix, increase SPI timeout for FRAM. In certain scenario's 100ms is too short.
    [FRAM.c]
2024-02-22 Revert "change: some expiremental testcode"
    This reverts commit 285daa9dd87f0820605e61a8c173c46c9a14f9c0.
    [mainTask.c, mainTask.h]
2024-02-22 Revert "change: temporary debug print for DevNonce check."
    This reverts commit 2bc55f9d5210bfaf0989fe50bbac6cfee801868c.
    [lora_app.c]
2024-02-22 Revert "change: temporary add some debug printing"
    This reverts commit 18119b2b0d49154dddc5e209bc790b57c5d0e695.
2024-02-22 Revert "change: add checking CRC of NVM data for founding reason of corrupt data"
    This reverts commit 92a2e719deb320093b408417cbafee6b5278ff60.
    [FRAM_functions.c]
2024-02-22 change: add function to print JoinNonce
2024-02-22 change: make helper function to print counters, add JoinNonce, and move to print always at powerup.
2024-02-22 change: modify layout of debug print
2024-02-23 change: rewrite state SWITCH_SENSOR_SLOT when no Sensor slots are active flow part 1.
2024-02-23 change: rewrite to send data also when no sensor is configured.
2024-02-26 change: add debug print for sensor init.
2024-02-27 change: also skip "NO_ACTIVE_COMMAND". In sensor module active status is delayed sometimes when sleepmode is active.
    [mainTask.c]
2024-02-27 Revert "change: temporary testcode for periodically fast test measuring"
    This reverts commit 27da65a9534f5f9d4f23a65b3d29085912a2a266.
    [mainTask.c]
2024-02-27 Revert "change: testcode to catch "no_active_command" status."
    This reverts commit 4a09ab21472cd628eb56dfbce54cbb8da328db18.
    [mainTask.c]
2024-02-27 change: rename sensorModuleEnabled to numberOfActiveSensorModules. To prepare use one round update.
2024-02-28 change: make test define for equal interval between measurements.
    Normally define SEND_MEASUREMENT_IN_EQUAL_INTERVAL must be disabled.
    Then each sensormodule measurements is send with interval of 1 minute between each module.
    After all sensors are send, then the LoraInterval - minus elapsed time is used.
2024-02-28 Revert "change: disable test define SEND_MEASUREMENT_IN_EQUAL_INTERVAL"
    This reverts commit 276c89b665b654105ada60c661af1cf7dfc37e1f.
    [mainTask.c]
2024-02-28 change: add some helper function to print debug lines with layout.
2024-02-28 change: print firmware version at boot.
2024-02-28 change: optmize debug print PrintCounter()
2024-02-28 change: move printCounters()
2024-02-28 change: make more readable debug print for printSensorModuleRoughData
2024-02-28 change: make more readable debug print for printSensorModulePressur() data
2024-02-28 change: add print base data to debug port.
2024-02-28 change: use verboselevel L for print firmware
2024-02-28 change: use verboseLevel M in function printBase data.
2024-02-28 change: print verboseLevel M for printSensorModulePressure
2024-02-28 change: use verboseLevel H for printSensorModule Rough data
2024-02-28 change: use verboseLevel L for print sensor module error
    [mainTask.c]
2024-02-28 change: move print functions to top, to be re-use in other functions
2024-02-28 change: modify checkForceRejoin with print layout.
2024-03-04 change: enable VSYS for detecting INTx 1-6 cause. Only debug printing.
2024-03-04 change: fix, by mistake wrong active level defined, must be LOW_ACTIVE.
    [board_io.c]
2024-03-04 change: make sure Ex2 wakeup is skipped, if ex1 is active. Because of pulse given from IC AM1805 itself.
    [mainTask.c]
2024-03-04 change: print all sensorModuleIndx from 1. Value 0-5, must be displayed at 1-6.
2024-03-04 change: store sensorModule Index in MFM data as value 1-6 (not 0-5).
2024-03-04 change: print MFM base data to measurement data
2024-03-06 change: modify routine to support separate init for each channel on one SensorModule Slot to get separate feedback.
2024-03-06 change: add sensor init failed to diagnostic data for channel 1 and channel 2.
    [FRAM_functions.h]
2024-03-06 change: reset init flag after the complete init cycle is finished.
    [mainTask.c]
2024-03-06 change: add enable diagnostic bit for sensor init channel 1 and channel 2.
2024-03-06 Revert "change: add temporary test code for periodically start forced init."
    This reverts commit 27df02df3374f9f3bfae70a5f4ad8bbda634f1d9.
    [mainTask.c]
2024-03-06 change: reset init flag when command is not available or init function not available.
    [mainTask.c]
2024-03-06 Revert "change: add some temporary test code for evaluating result of init."
    This reverts commit 7f451888f75901a3b00ea6ab01211f052ad3347c.
    [mainTask.c]
2024-03-07 change: also set new JoinID and DeviceID after change detect, simular to AppKey. Not really needed.
2024-03-07 change: update debug print for HUBA sensormodule with rough values.
2024-03-07 change: add command to enable slot1 power, for programming sensor board.
2024-03-07 change: reset board for disable slot1 supply.
    [board_io_test.c]
2024-03-11 change: correct doxygen comment
    [SensorRegister.h]
2024-03-11 change: fix some doxygen warnings
    [BatMon_functions.c, CommConfig.c, MFMconfiguration.c, RTC_functions.c, board_io.c, dataflash_functions.c, mainTask.c]
2024-03-12 change: add instruction for programming USB rx/tx Leds
2024-03-13 change: add procedure battery configuration
2024-03-14 change: correcting too short interval with 1 sensor
    [mainTask.c]
2024-03-14 change: prevent hanging in while(1) at sleep, prevent with reset of system.
    [RTC_functions.c, common.c, mainTask.c]
2024-04-02 change: add debug print wrong VSYS setting
    [board_io.c]
2024-04-02 change: add debug print enable/disable vsys
2024-04-02 change: add debug print vsys verify in sate where hanging starts.
2024-04-02 change: expand command rejoin with reset counters with optional byte.
    [mainTask.c]
2024-04-02 change: add function to reset watchdog
    [common.c, common.h]
2024-04-02 change: use function with timeout. A wrapper is used to print result to debug port.
2024-04-02 change: normal printf changed to APP_LOG().
2024-04-03 Fix: correct mistake in get+Sample, add missing senosr ID in return message
    [CommConfig.c]
2024-04-04 change: also init HAL I2C in productiontestTask, otherwise it could fail.
    [productiontestTask.c]
2024-04-04 change: add missing return value.
    [IO_Expander.c, board_io.c]
2024-04-04 change: add retry for I2C I/O expander.
2024-04-04 change: detect entering not possible state. Must be a bug then.
    [mainTask.c]
2024-04-05 change: add bit4 (0x10) for trigger sensor initialization with a rejoin.
2024-04-05 change: also reset joinNOnce when Join settings are changed. On request of Tim van Osch for changing server.
    [CommConfig.c]
2024-04-05 change: enable bits in FRAM struct also, to trigger forced sensor init next round.
2024-04-08 change: add failure counter
    [IO_Expander.c, IO_Expander.h]
2024-04-08 change: add checking on I2C error, try to repair. Otherwise reboot.
    [mainTask.c]
2024-04-08 change: print some debug info.
2024-04-09 change: correct format type variable
    [mainTask.c]
2024-04-09 change: correct I2C var. By mistake copy of ch 1, must be ch 2.
    [i2c.c]
2024-04-22 change: add function to indicate a new battery is placed.
2024-06-19 chore: Add hardware from release
    [BatteryMonitor.SchDoc, MCU.SchDoc, MCU_RF.SchDoc, Mechanical.SchDoc, Memory.SchDoc, P22296-1.PrjPcb, Power1.SchDoc, Power2.SchDoc]
2024-10-31 update sources to 0.2.05 w/ i2c var read patch
2025-04-15 docs(accessories): add borehole adapter
    [3D Cap 160mm borehole.stl, 3D Cap Electronics platform 160mm.step, 3D Cap temporary boreholes.step, Adapter_MFM-V4_115mm.SLDPRT, Adapter_MFM-V4_115mm.STL, Adapter_MFM-V4_160mm.SLDPRT, Adapter_MFM-V4_160mm.STL]
2025-04-16 docs: rename borehole to well
    [3D Cap Electronics platform 160mm.step, 3D Well Cap 160mm.stl, 3D Well Cap temporary.step, Adapter_MFM-V4_115mm.SLDPRT, Adapter_MFM-V4_115mm.STL, Adapter_MFM-V4_160mm.SLDPRT, Adapter_MFM-V4_160mm.STL]
2025-12-12 Chore: ignore stm32 pref file
2026-01-05 refactor: update stm32mx generator version, port to cmake.
2026-06-30 Revert "refactor: update stm32mx generator version, port to cmake."
    This reverts commit 205dc3a62353d5a6eae9f492de96566c72787412.
    [FRAM_functions.c, P22296-10-SW.ioc, common.c, i2c.c, lora_app.c, main.c, mainTask.c]
