Multiflexmeter/Multiflexmeter/(notices)

Notices in the files:
src/LoRaWAN/App/lora_app.c:
Copyright (c) 2023 STMicroelectronics.
All rights reserved.
This software is licensed under terms that can be found in the LICENSE file
src/App/pingpong/subghz_phy_app.c:
Copyright (c) 2021 STMicroelectronics.
